LeslieXMOS/XU316-QF60-Development-Board-Hardware/EASYEDA_MODELS/IND-SMD_L7.0-W6.6-H3.0.step

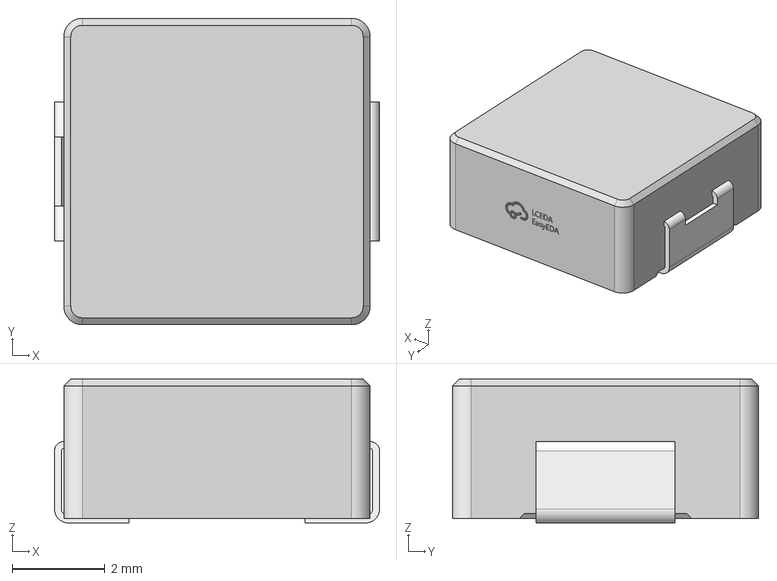
[picture p1: CAD file, 2026-09-23]
EASYEDA_MODELS/IND-SMD_L7.0-W6.6-H3.0.step
7.00 x 6.60 x 3.10 mm
