LeslieXMOS/XU316-QF60-Development-Board-Hardware/EASYEDA_MODELS/WSON-8_L8.0-W6.0-P1.27-TL-EP-1.step

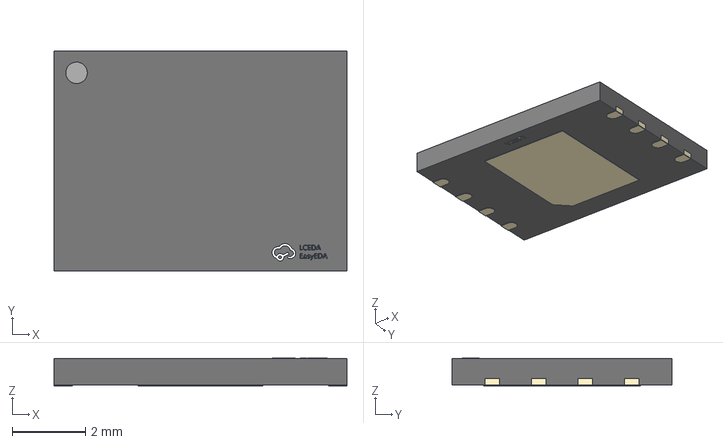
[picture p2: CAD file, 2026-09-11]
EASYEDA_MODELS/WSON-8_L8.0-W6.0-P1.27-TL-EP-1.step
8.00 x 6.00 x 0.751 mm
