LeslieXMOS/XU316-QF60-Development-Board-Hardware/EASYEDA_MODELS/SC-88-6P_L2.0-W1.3-H1.0-LS2.1.step

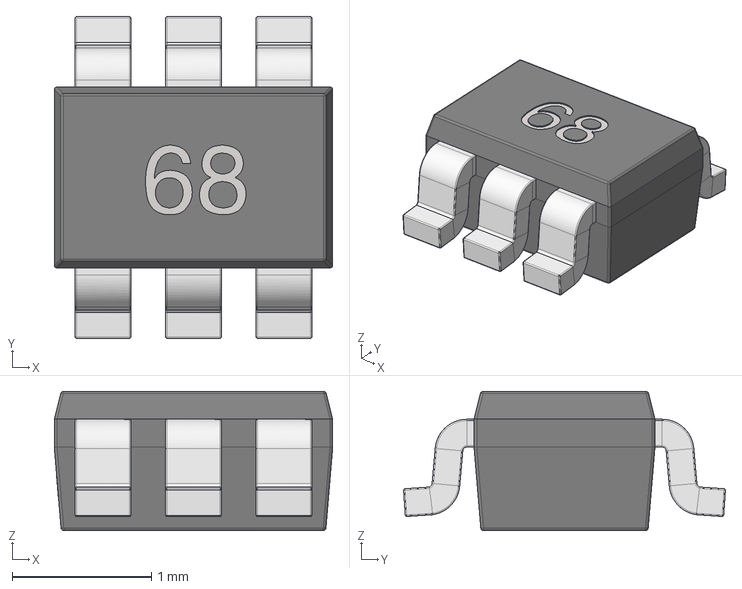
[picture p3: CAD file, 2026-09-11]
EASYEDA_MODELS/SC-88-6P_L2.0-W1.3-H1.0-LS2.1.step
2.00 x 2.31 x 1.00 mm
