LeslieXMOS/XU316-QF60-Development-Board-Hardware/EASYEDA_MODELS/USB-C-SMD_TYPE-C-6PIN-2MD-073.step

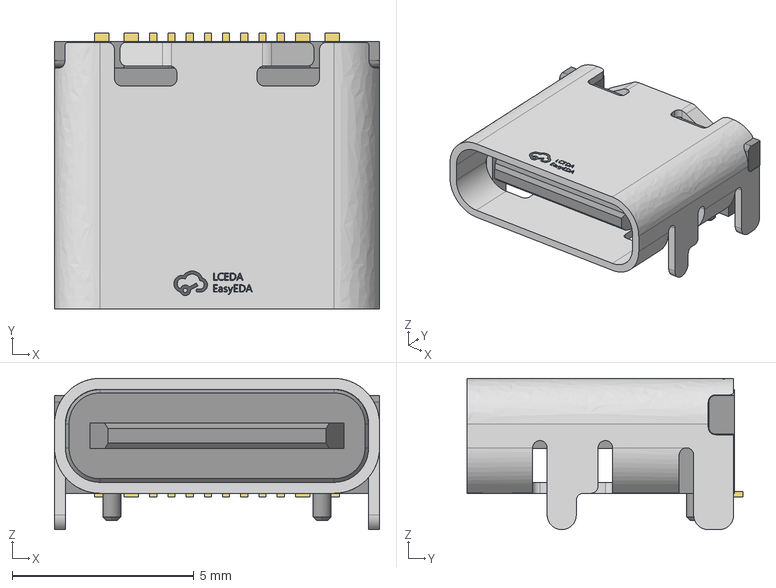
[picture p4: CAD file, 2026-09-11]
EASYEDA_MODELS/USB-C-SMD_TYPE-C-6PIN-2MD-073.step
8.94 x 7.58 x 4.16 mm
