LeslieXMOS/XU316-QF60-Development-Board-Hardware/EASYEDA_MODELS/SOT-563-6_L1.6-W1.2-P0.5-LS1.6-BL.step

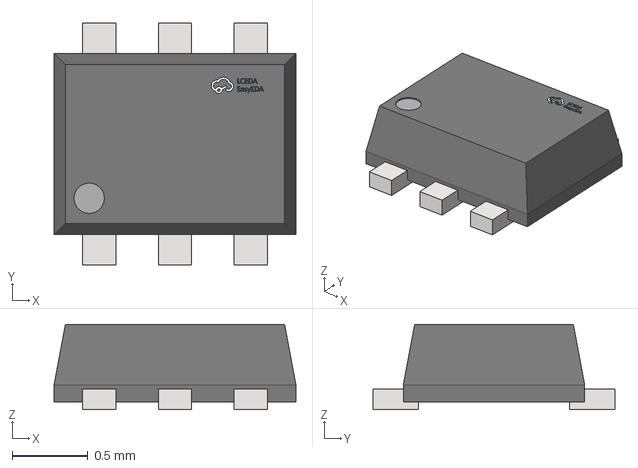
[picture p5: CAD file, 2026-09-11]
EASYEDA_MODELS/SOT-563-6_L1.6-W1.2-P0.5-LS1.6-BL.step
1.60 x 1.60 x 0.563 mm
