LeslieXMOS/XU316-QF60-Development-Board-Hardware/EASYEDA_MODELS/QFN-60_L7.0-W7.0-P0.40-TL-EP_XU316-1024.step

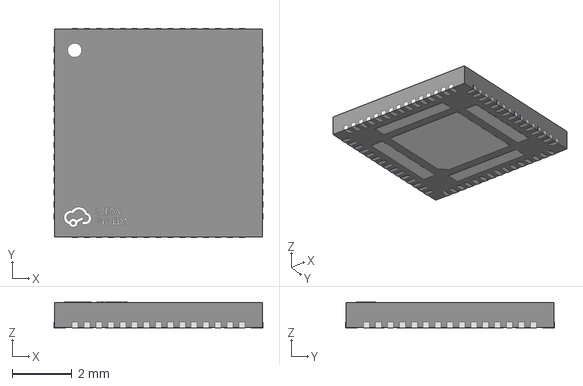
[picture p6: CAD file, 2026-09-11]
EASYEDA_MODELS/QFN-60_L7.0-W7.0-P0.40-TL-EP_XU316-1024.step
7.02 x 7.02 x 0.87 mm
