LeslieXMOS/XU316-QF60-Development-Board-Hardware/EASYEDA_MODELS/WSON-12_L3.0-W3.0-P0.50-TL-EP-2.step

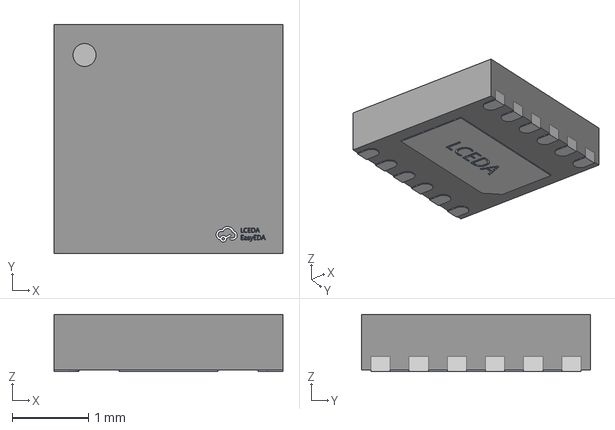
[picture p7: CAD file, 2026-09-11]
EASYEDA_MODELS/WSON-12_L3.0-W3.0-P0.50-TL-EP-2.step
3.00 x 3.00 x 0.751 mm
