LeslieXMOS/XU316-QF60-Development-Board-Hardware/EASYEDA_MODELS/CONN-TH_20P-P1.27_BH127V-20P-H49.step

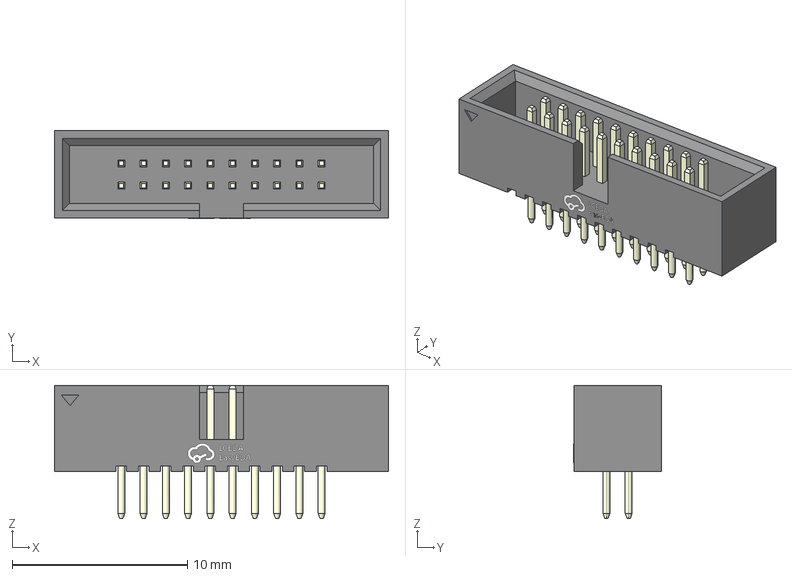
[picture p8: CAD file, 2026-09-11]
EASYEDA_MODELS/CONN-TH_20P-P1.27_BH127V-20P-H49.step
19.1 x 5.01 x 7.60 mm
