LeslieXMOS/XU316-QF60-Development-Board-Hardware/EASYEDA_MODELS/USON-8_L4.0-W3.0-H0.6-P0.80-BL_GD25Q32CNIGR.step

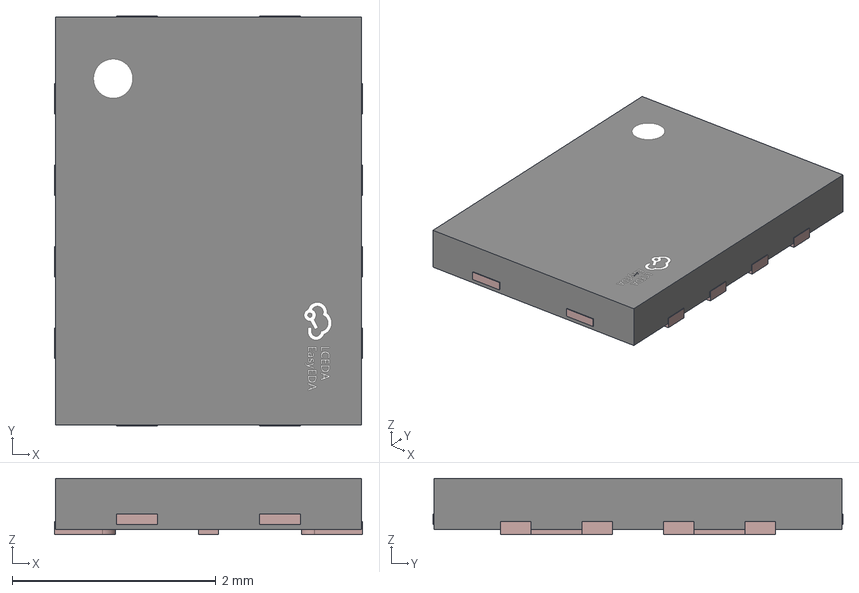
[picture p9: CAD file, 2026-09-11]
EASYEDA_MODELS/USON-8_L4.0-W3.0-H0.6-P0.80-BL_GD25Q32CNIGR.step
3.02 x 4.02 x 0.551 mm
