LeslieXMOS/XU316-QF60-Development-Board-Hardware/EASYEDA_MODELS/SOT-563-6P_L1.6-W1.2-H0.6-LS1.6-P0.50.step

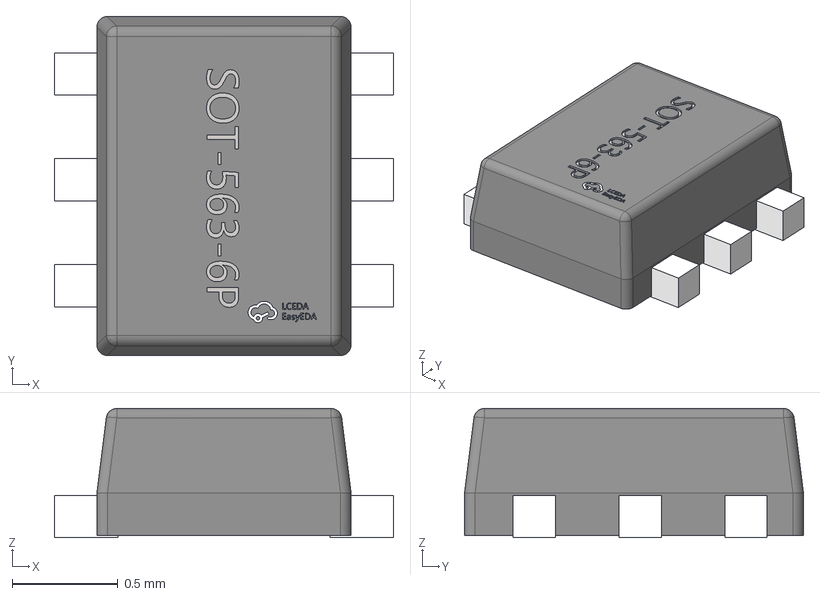
[picture p10: CAD file, 2026-09-11]
EASYEDA_MODELS/SOT-563-6P_L1.6-W1.2-H0.6-LS1.6-P0.50.step
1.60 x 1.60 x 0.611 mm
