LeslieXMOS/XU316-QF60-Development-Board-Hardware/EASYEDA_MODELS/VSON-10_L3.0-W3.0-H0.6-P0.50_TPS.step

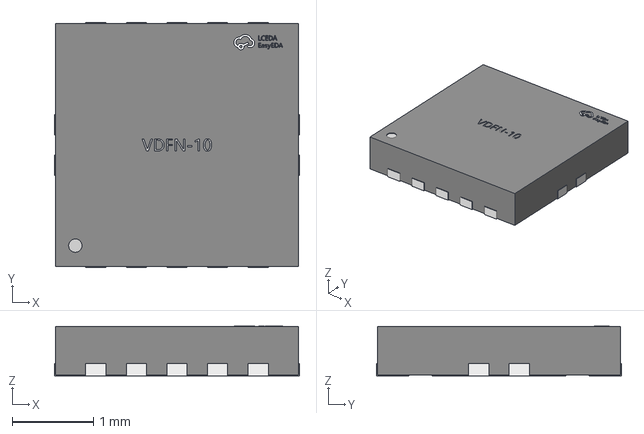
[picture p11: CAD file, 2026-09-11]
EASYEDA_MODELS/VSON-10_L3.0-W3.0-H0.6-P0.50_TPS.step
3.02 x 3.02 x 0.611 mm
