LeslieXMOS/XU316-QF60-Development-Board-Hardware/xu316_core_board_pcb.pdf

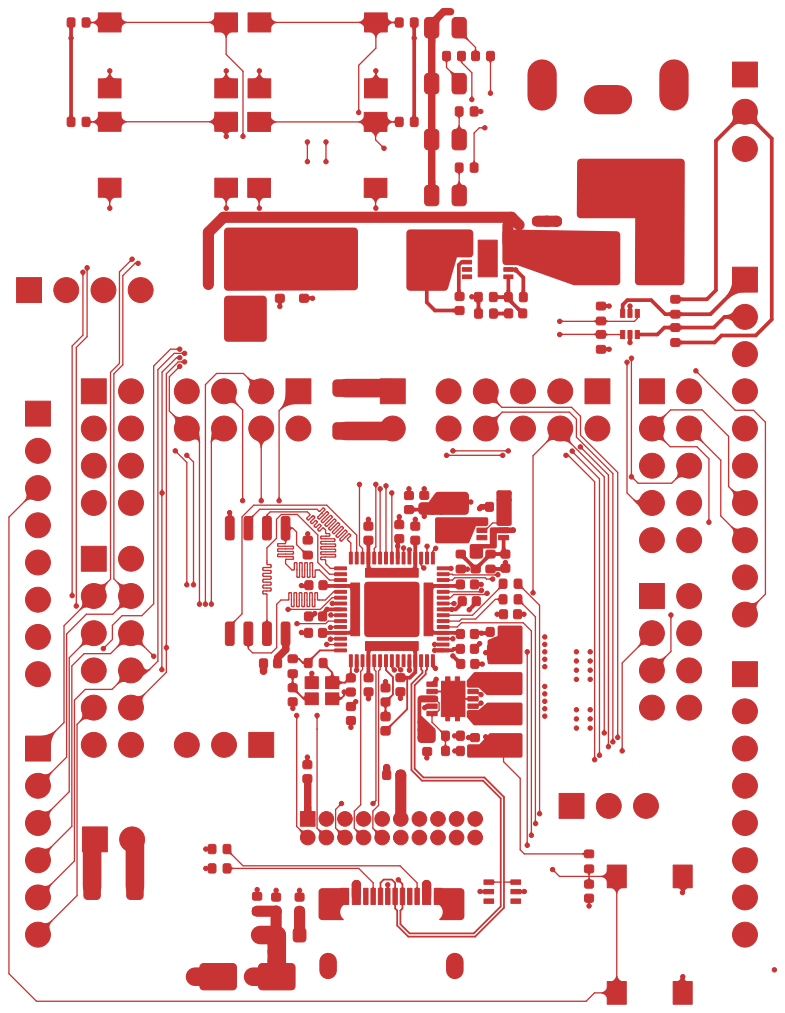
[picture p12: page 1]

Id: 1/11 Title: File: xu316_core_board.kicad_pcb Sheet:

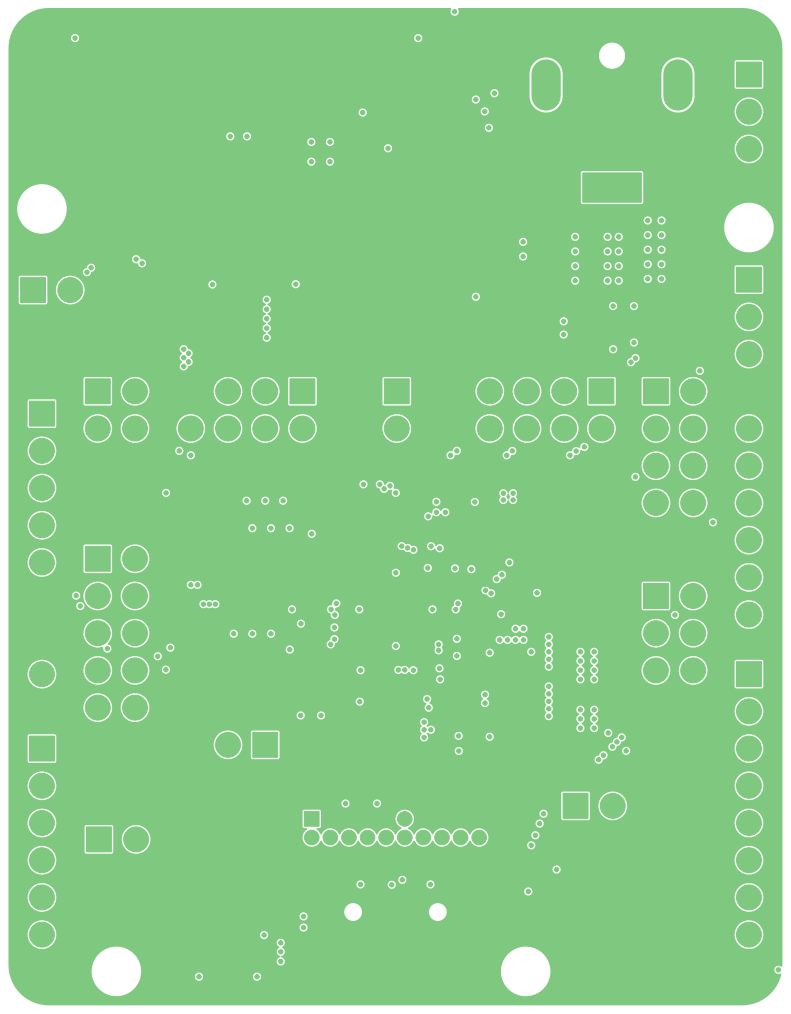
[picture p13: page 2]

Id: 2/11 Title: File: xu316_core_board.kicad_pcb Sheet:

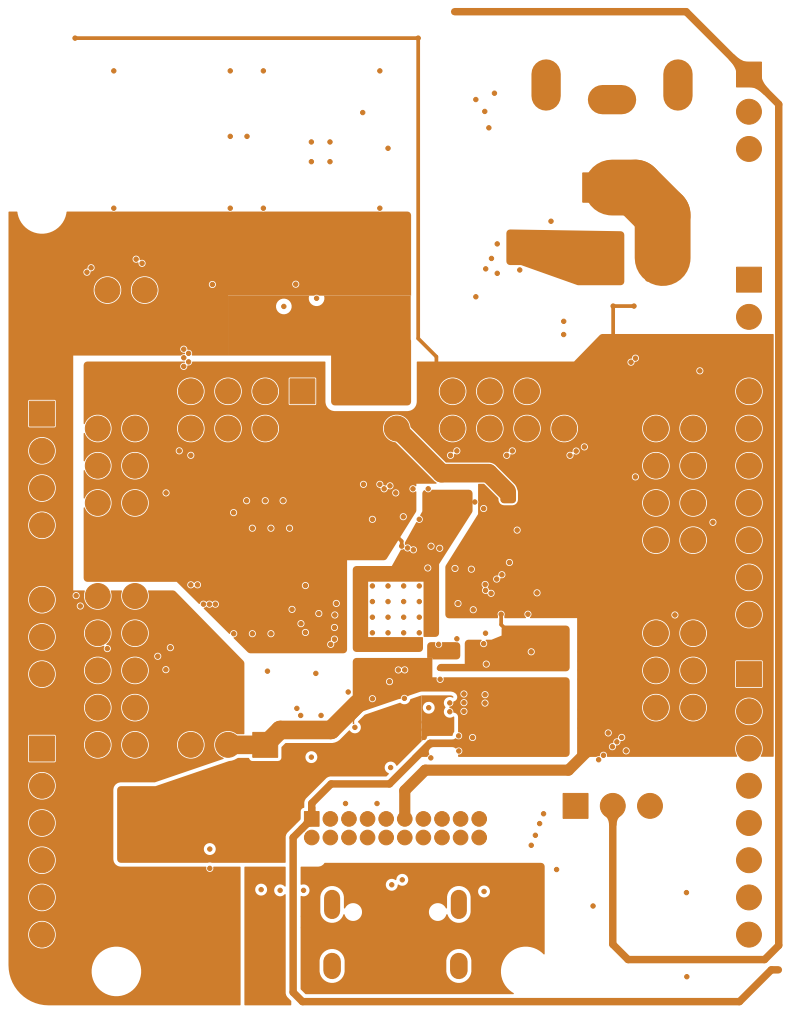
[picture p14: page 3]

Id: 3/11 Title: File: xu316_core_board.kicad_pcb Sheet:

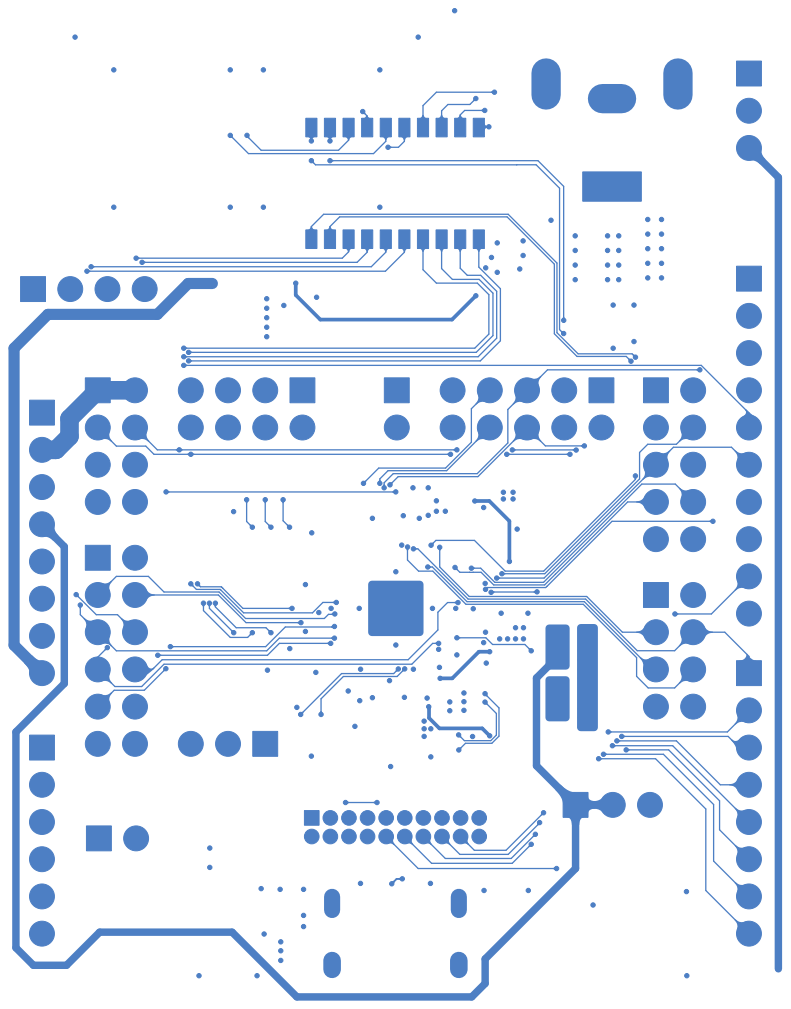
[picture p15: page 4]

Id: 4/11 Title: File: xu316_core_board.kicad_pcb Sheet:

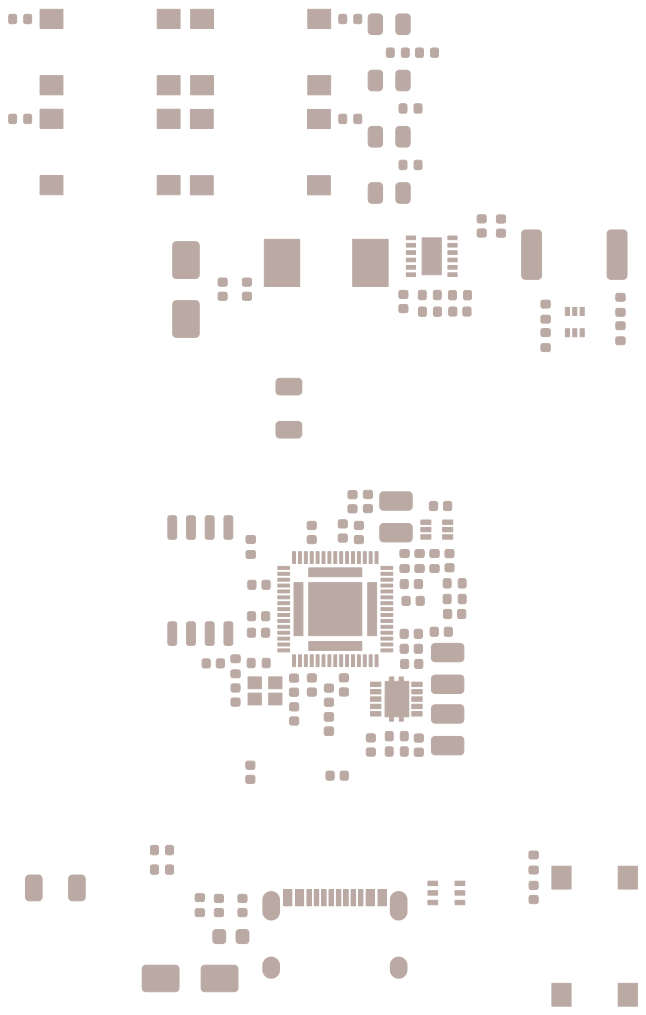
[picture p16: page 5]

Id: 5/11 Title: File: xu316_core_board.kicad_pcb Sheet:

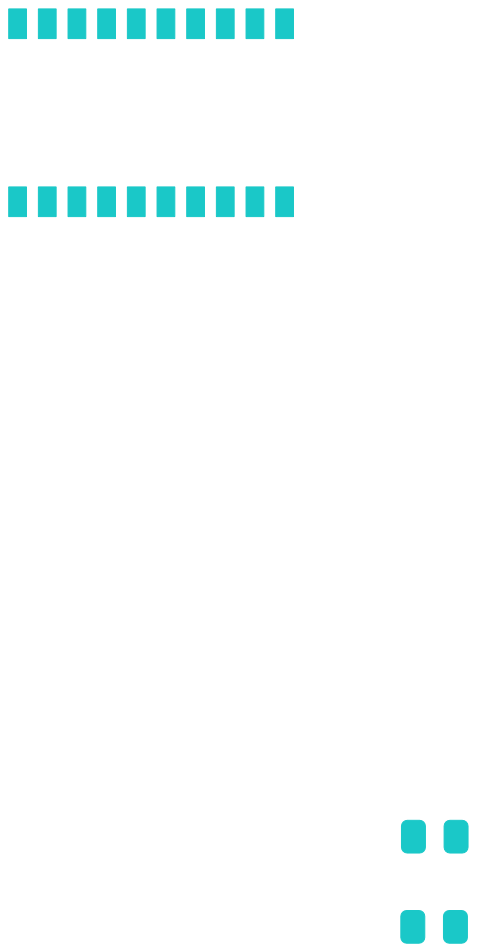
[picture p17: page 6]

Id: 6/11 Title: File: xu316_core_board.kicad_pcb Sheet:

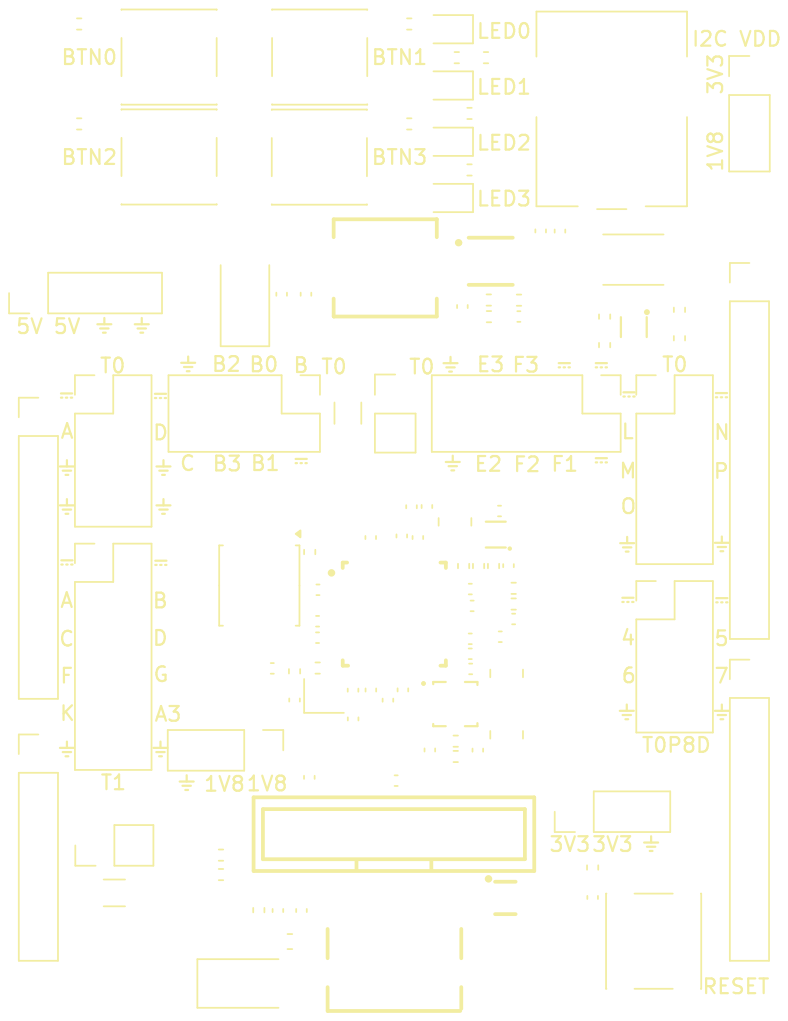
[picture p18: page 7]

Id: 7/11 Title: File: xu316_core_board.kicad_pcb Sheet:

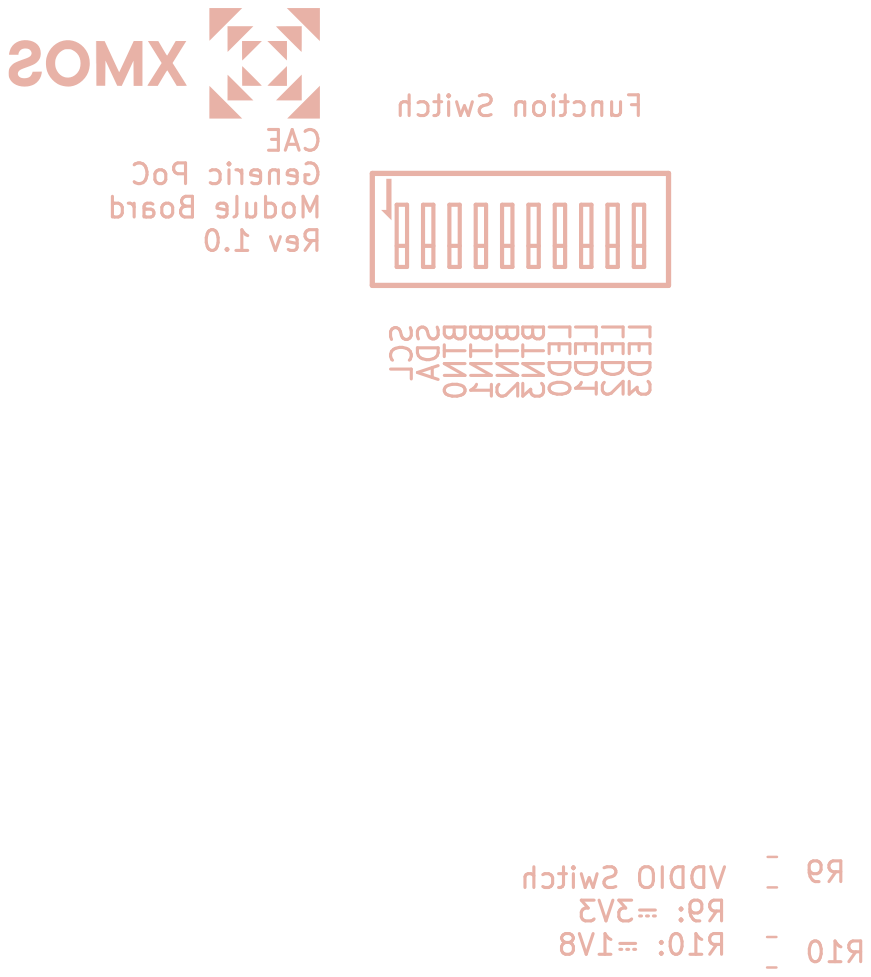
[picture p19: page 8]

Id: 8/11 Title: File: xu316_core_board.kicad_pcb Sheet:

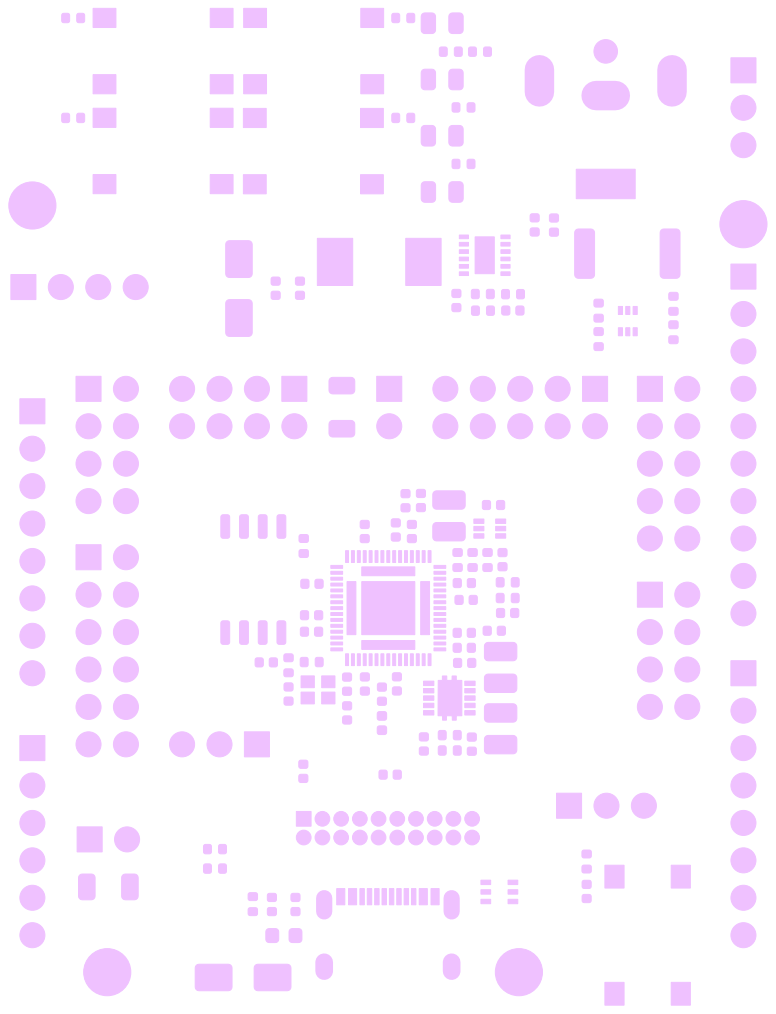
[picture p20: page 9]

Id: 9/11 Title: File: xu316_core_board.kicad_pcb Sheet:

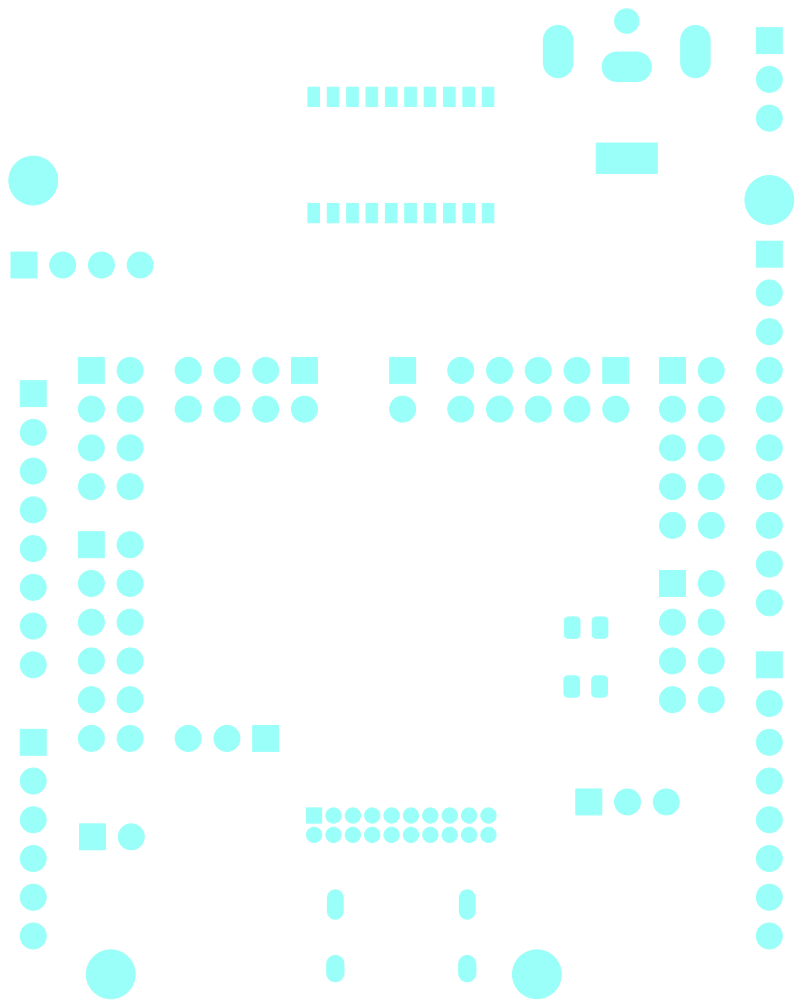
[picture p21: page 10]

Id: 10/11 Title: File: xu316_core_board.kicad_pcb Sheet:

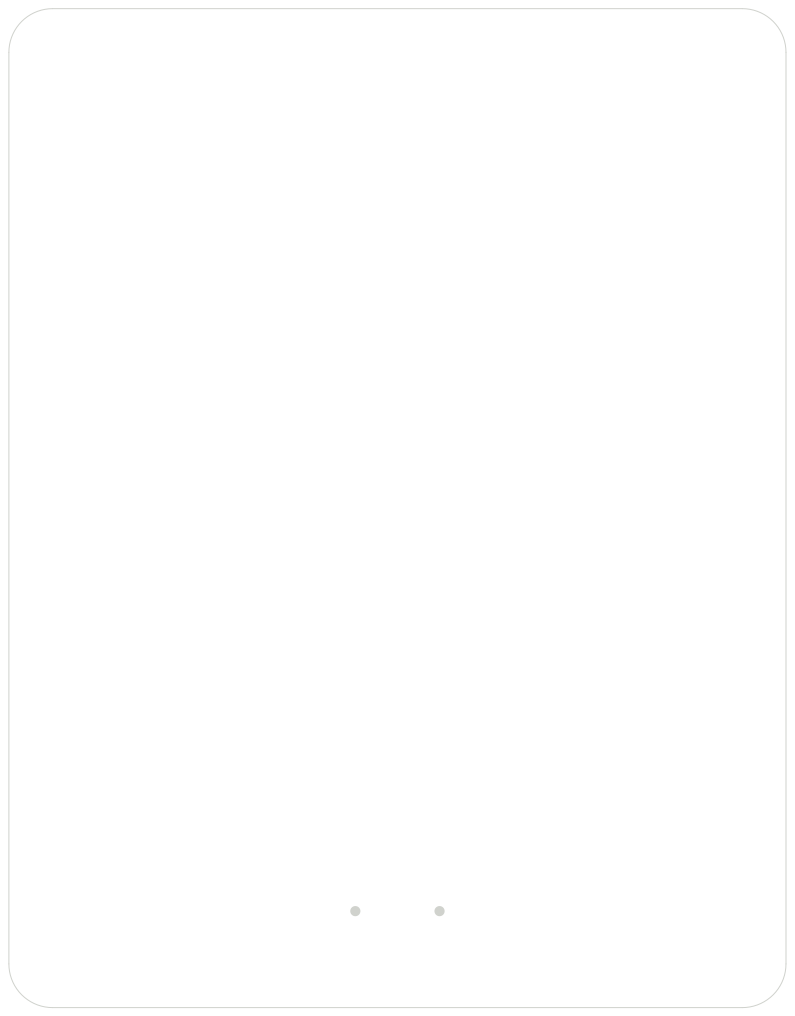
[picture p22: page 11]

Id: 11/11 Title: File: xu316_core_board.kicad_pcb Sheet:
