LeslieXMOS/XU316-QF60-Development-Board-Hardware/xu316_core_board_sch.pdf

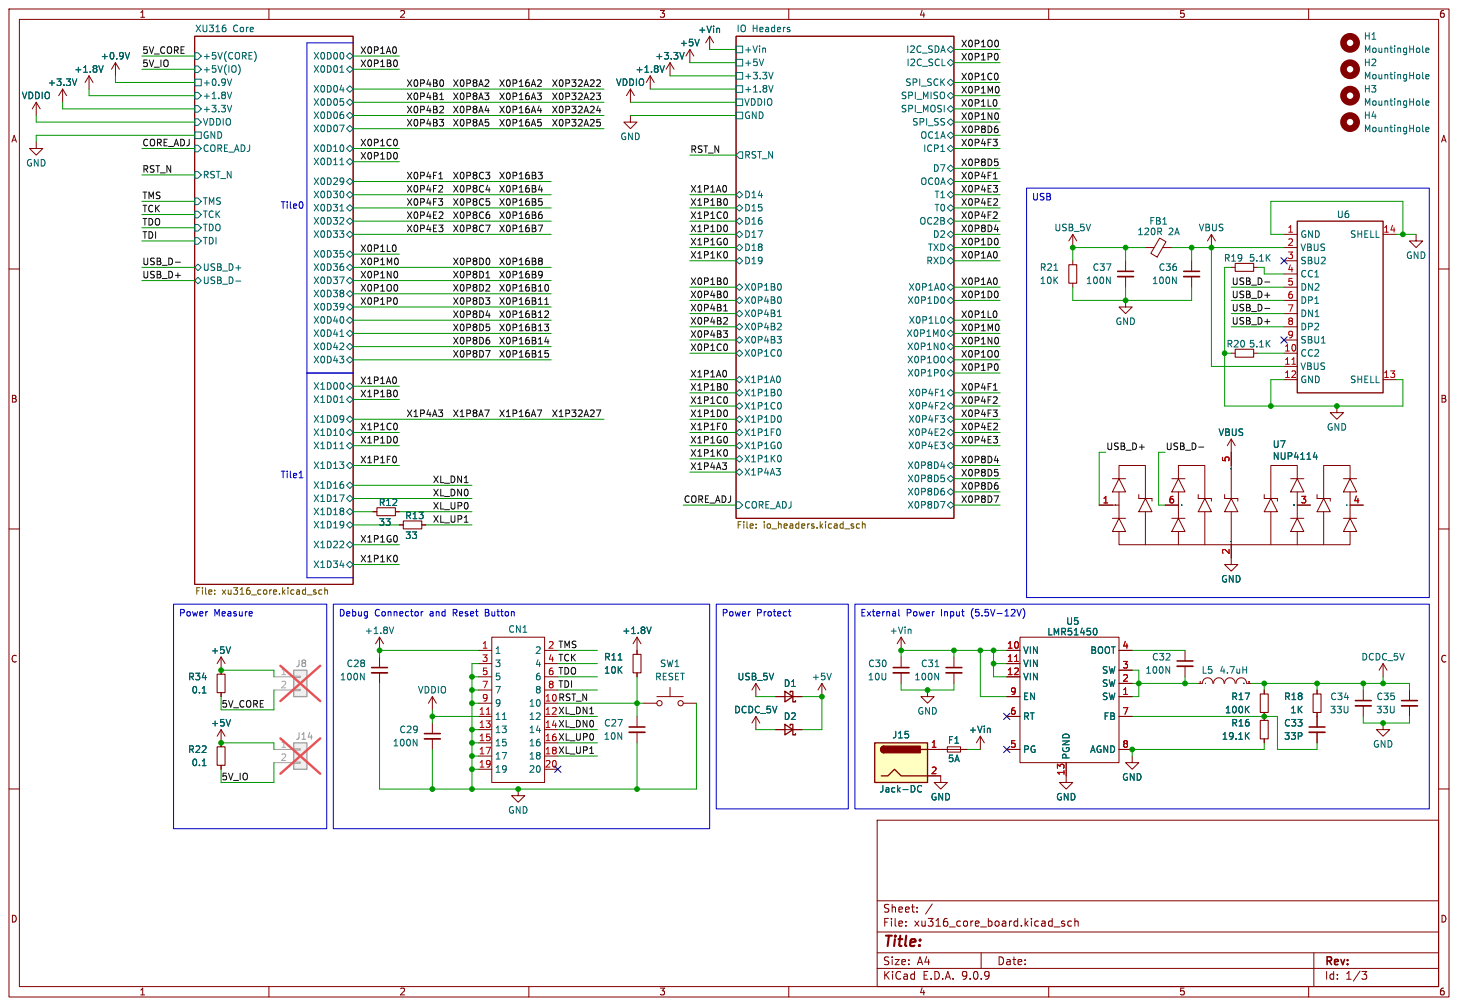
[picture p23: page 1]

Id: 1/3 Title: File: xu316_core_board.kicad_sch Sheet: /

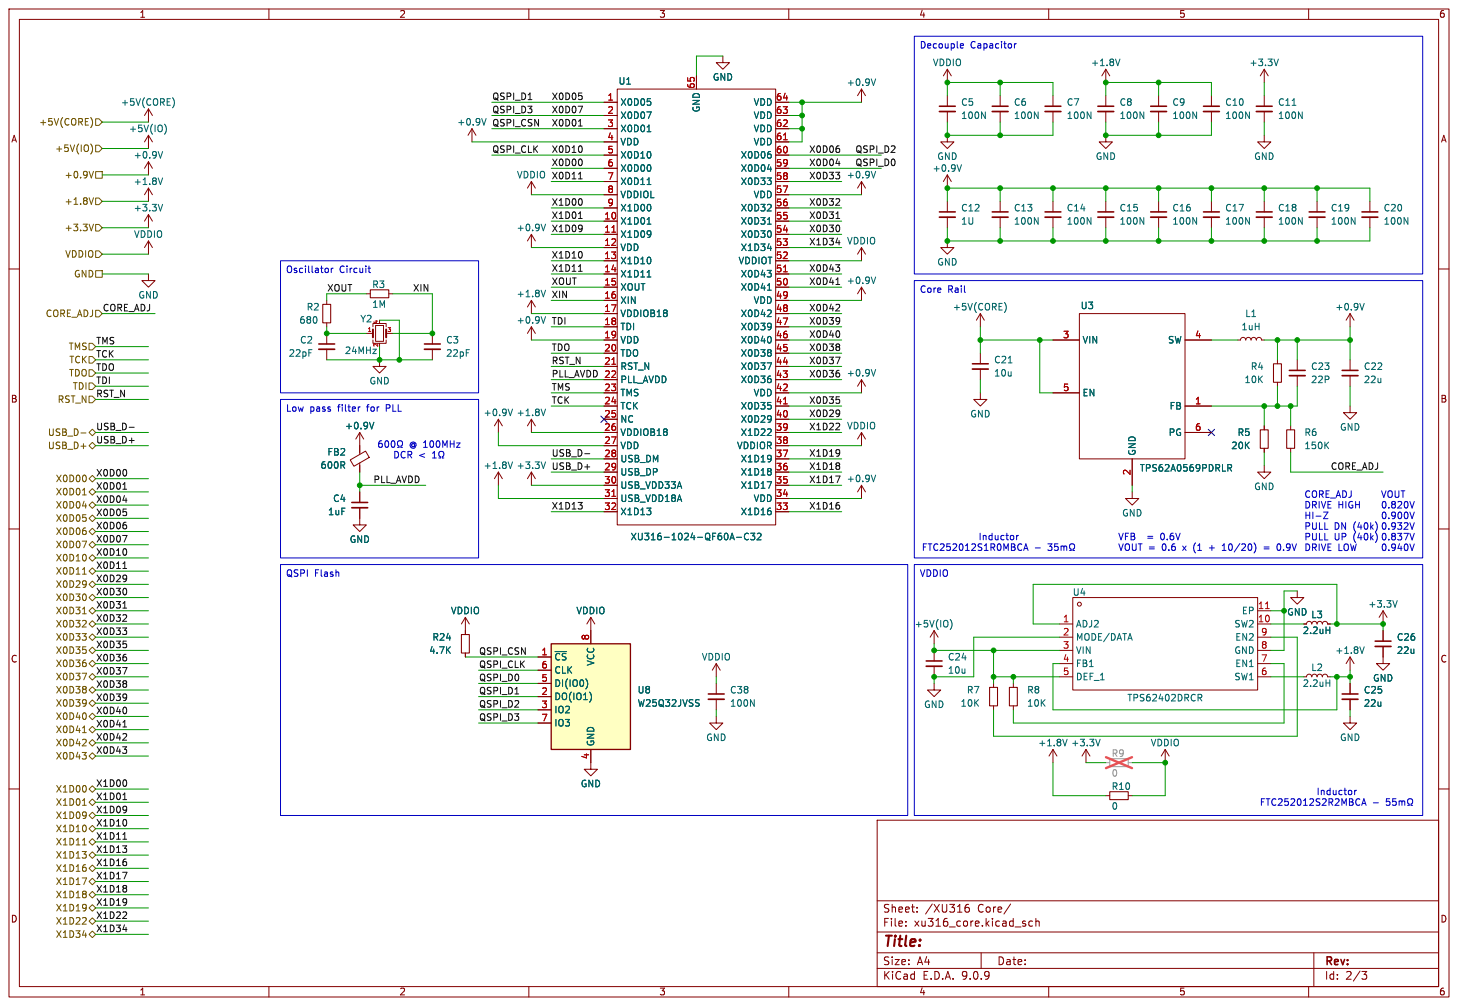
[picture p24: page 2]

2 SW 4 FB 1 PG 6 U3 TPS62A0569PDRLR GND

HI-Z PULL DN (40k) PULL UP (40k) DRIVE LOW

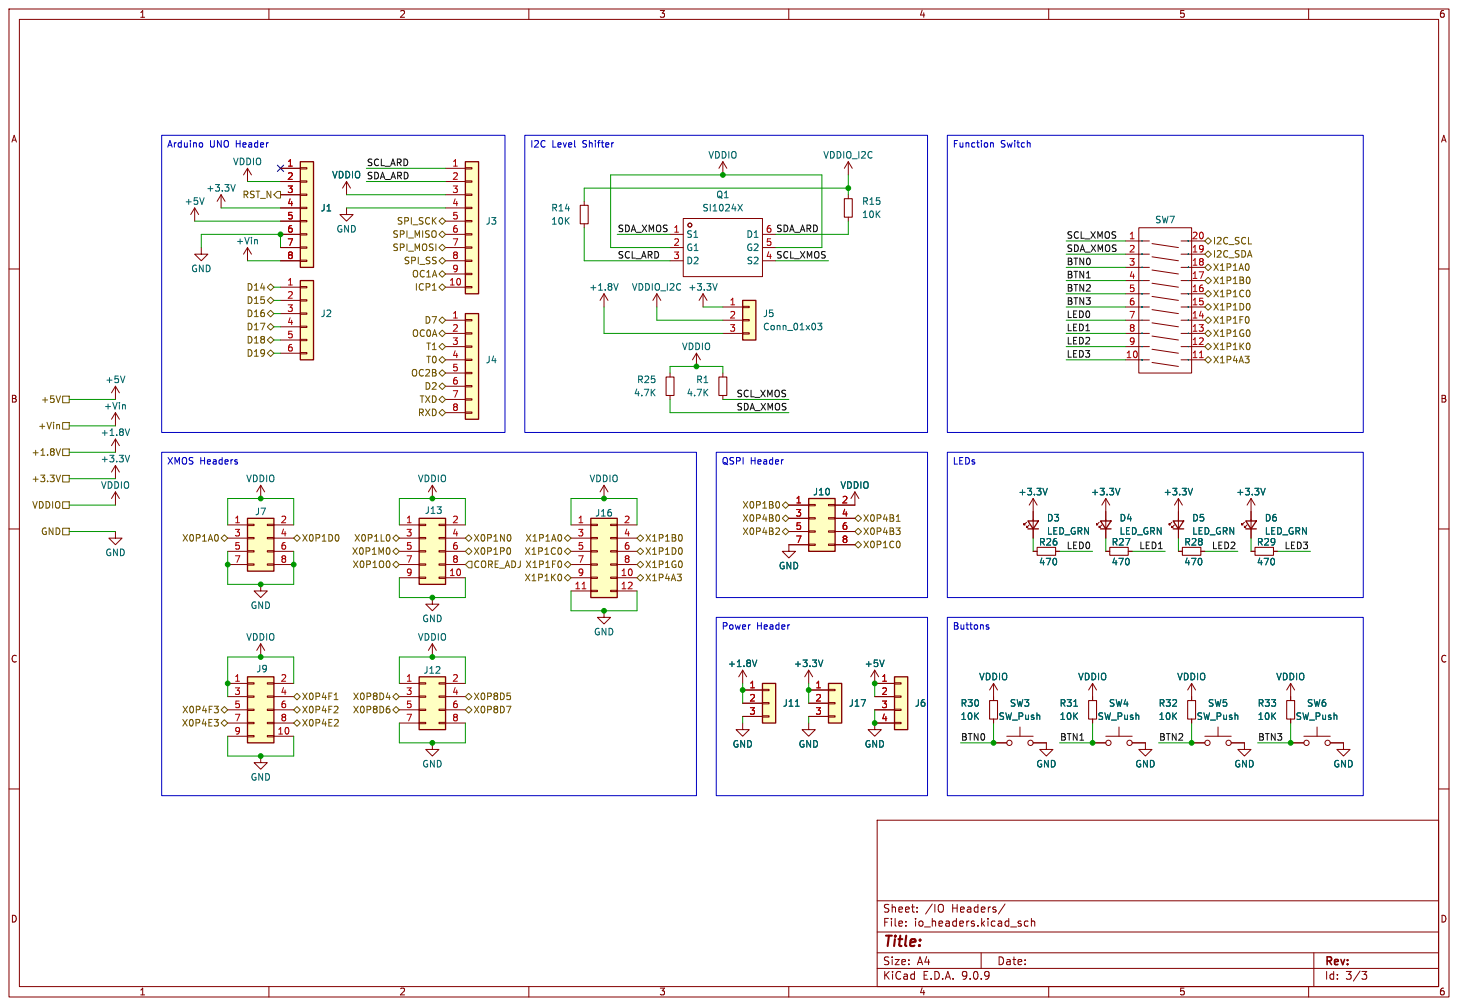
[picture p25: page 3]
