LeslieXMOS/XU316-QF60-Development-Board-Hardware/xu316_core_board.kicad_pcb

## KiCad design xu316_core_board.kicad_pcb (2026-09-29)

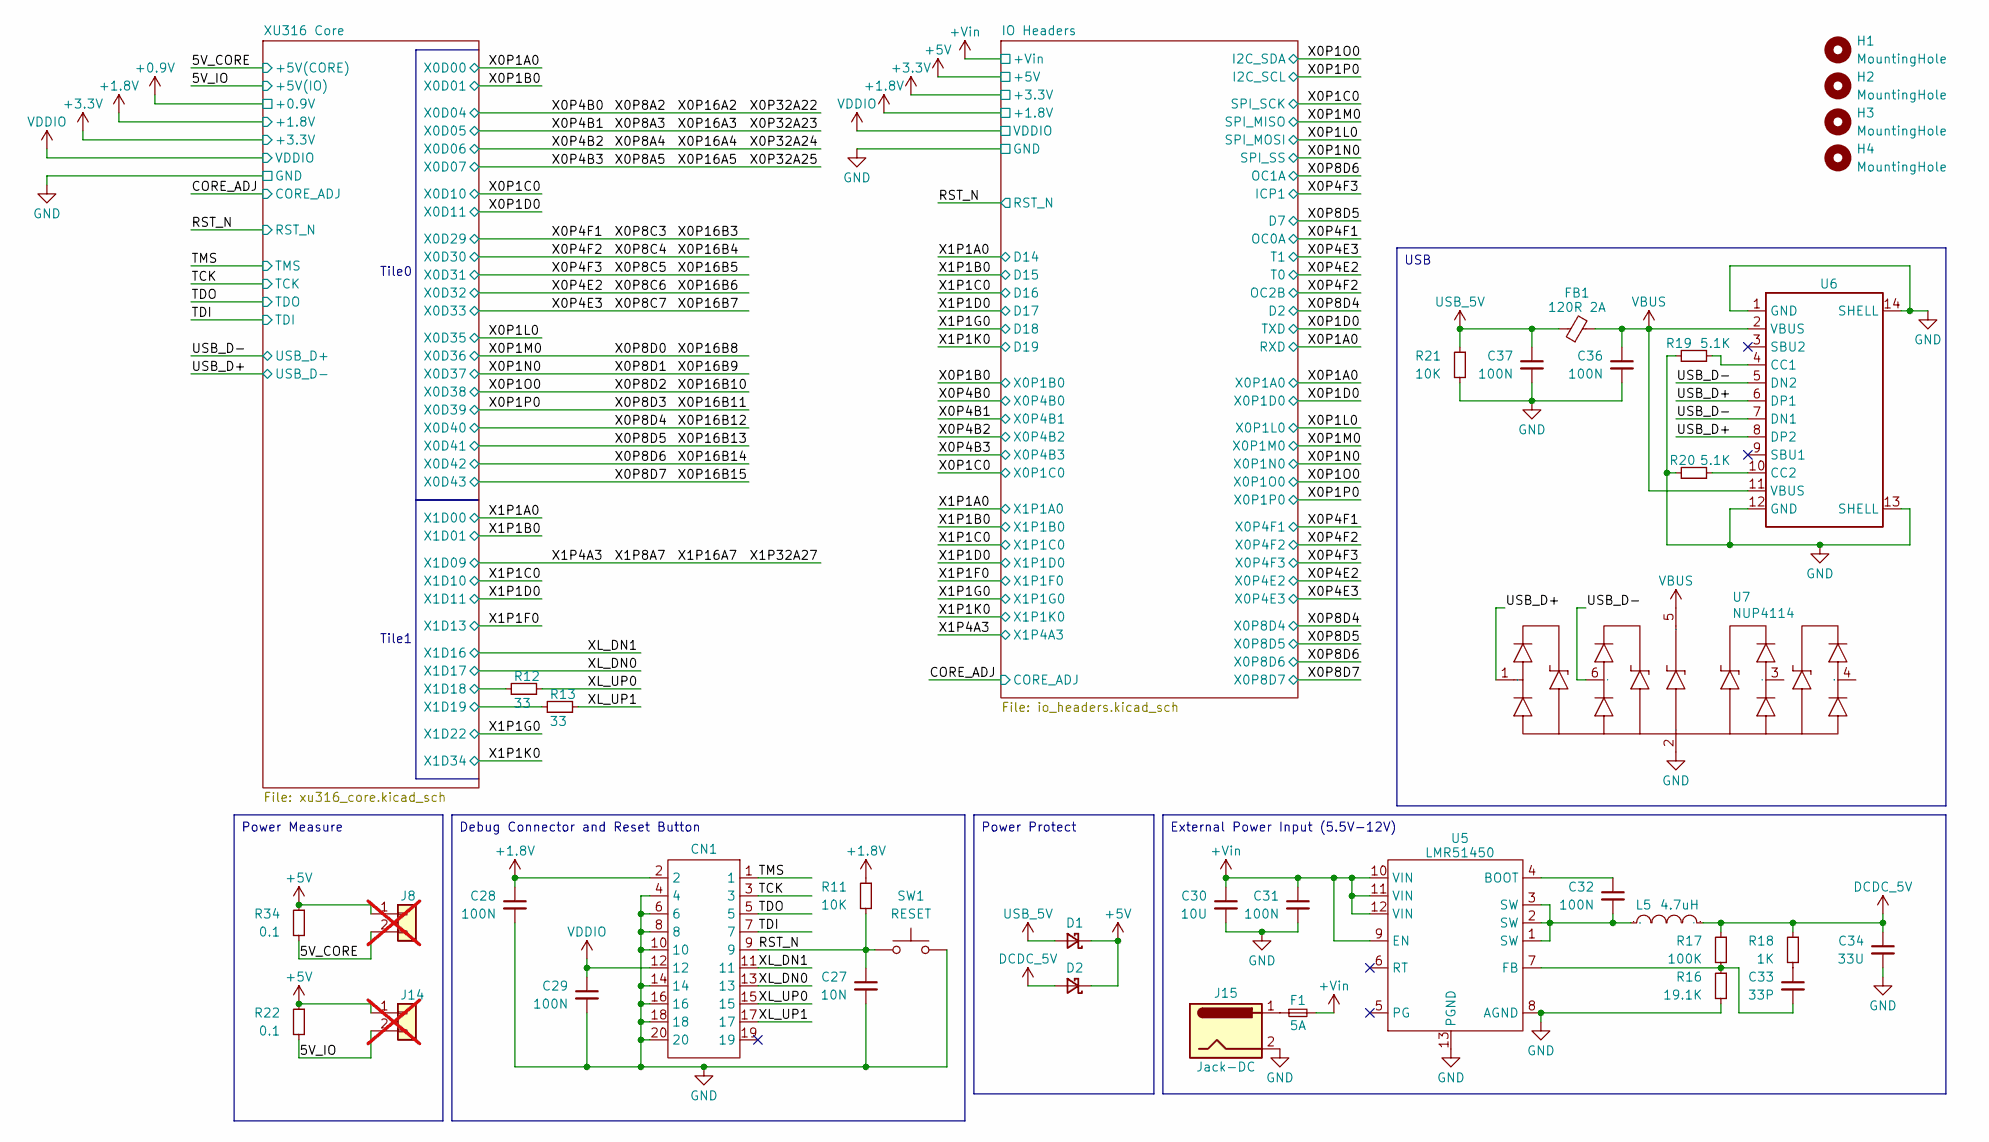
[picture p26: schematic xu316_core_board.kicad_sch]

Parts:
C27: 10N; C_0402_1005Metric
C28, C29, C31, C32, C36, C37: 100N; C_0402_1005Metric
C30: 10U; C_1206_3216Metric
C33: 33P; C_0402_1005Metric
C34: 33U; CP_Elec_4x5.4; JLCParts C53200078
CN1: HX JN1.27-2x10P ZZ H4.9; CONN-TH_20P-P1.27_BH127V-20P-H49; Manufacturer Part HX JN1.27-2x10P ZZ H4.9; LCSC Part Name 1.27mm 2x10P 排数:2 每排P数:10
D1, D2: D_Schottky_Small; D_SMA
F1: 5A; Fuse_2512_6332Metric
FB1: 120R 2A; L_0603_1608Metric
H1, H2, H3, H4: MountingHole; MountingHole_3.2mm_M3
J8, J14: Conn_01x02; PinHeader_1x02_P2.54mm_Vertical; not fitted
J15: Jack-DC; BarrelJack_GCT_DCJ200-10-A_Horizontal
L5: 4.7uH; IND-SMD_L7.0-W6.6; Manufacturer Part FXL0630-4R7-M; LCSC Part Name 4.7uH ±20% 9A
R11, R21: 10K; R_0402_1005Metric
R12, R13: 33; R_0402_1005Metric
R16: 19.1K; R_0402_1005Metric
R17: 100K; R_0402_1005Metric
R18: 1K; R_0402_1005Metric
R19, R20: 5.1K; R_0402_1005Metric
R22, R34: 0.1; R_1206_3216Metric; JLCPart C411236
SW1: RESET; SW_Push_1P1T_NO_6x6mm_H9.5mm
U5: LMR51450; WSON-12_L3.0-W3.0-P0.50-TL-EP-2; Manufacturer Part LMR51450FNDRRR; LCSC Part Name 降压型 5A 4V~36V
U6: USB-C-SMD_TYPE-C-6PIN-2MD-073; Manufacturer Part TypeC-16PIN; LCSC Part Name TypeC-16PIN
U7: NUP4114; SC-88-6_L2.0-W1.3-P0.65-LS2.1-BL; Manufacturer Part NUP4114UCLW1T1G; LCSC Part Name NUP4114UCLW1T1G 停产

Connections:
+1.8V: C28.1, CN1.2, R11.1; also elsewhere on the board
+5V: D1.1 (K), D2.1 (K), J8.1, J14.1, R22.1, R34.1; also elsewhere on the board
+5V(CORE): J8.2, R34.2; also elsewhere on the board
+5V(IO): J14.2, R22.2; also elsewhere on the board
+Vin: C30.1, C31.1, F1.2, U5.9 (EN), U5.10 (VIN), U5.11 (VIN), U5.12 (VIN); also elsewhere on the board
/RST_N: C27.1, CN1.9, R11.2, SW1.1; also elsewhere on the board
/TCK: CN1.3; also elsewhere on the board
/TDI: CN1.7; also elsewhere on the board
/TDO: CN1.5; also elsewhere on the board
/TMS: CN1.1; also elsewhere on the board
/USB_D+: U6.6 (DP1), U6.8 (DP2), U7.1; also elsewhere on the board
/USB_D-: U6.5 (DN2), U6.7 (DN1), U7.6; also elsewhere on the board
/XL_DN0: CN1.13; also elsewhere on the board
/XL_DN1: CN1.11; also elsewhere on the board
/XL_UP0: CN1.15, R12.1
/XL_UP1: CN1.17, R13.1
/XU316 Core/X1D18: R12.2; also elsewhere on the board
/XU316 Core/X1D19: R13.2; also elsewhere on the board
DCDC_5V: C34.1, D2.2 (A), L5.2, R17.1, R18.1
GND: C27.2, C28.2, C29.2, C30.2, C31.2, C34.2, C36.2, C37.2, CN1.4, CN1.6, CN1.8, CN1.10, CN1.14, CN1.16, CN1.18, CN1.20, J15.2, R16.2, R19.2, R20.2, R21.2, SW1.2, U5.8 (AGND), U5.13 (PGND), U6.1 (GND), U6.12 (GND), U6.13 (SHELL), U6.14 (SHELL), U7.2; also elsewhere on the board
unnamed: C32.2, L5.1, U5.1 (SW), U5.2 (SW), U5.3 (SW)
unnamed: C33.1, R18.2
unnamed: F1.1, J15.1
unnamed: C32.1, U5.4 (BOOT)
unnamed: C33.2, R16.1, R17.2, U5.7 (FB)
unnamed: R19.1, U6.4 (CC1)
unnamed: R20.1, U6.10 (CC2)
USB_5V: C37.1, D1.2 (A), FB1.1, R21.1
VBUS: C36.1, FB1.2, U6.2 (VBUS), U6.11 (VBUS), U7.5
VDDIO: C29.1, CN1.12; also elsewhere on the board

Notes on the sheet:
Tile0
Tile1
Debug Connector and Reset Button
Power Protect
External Power Input (5.5V-12V)
USB
Power Measure

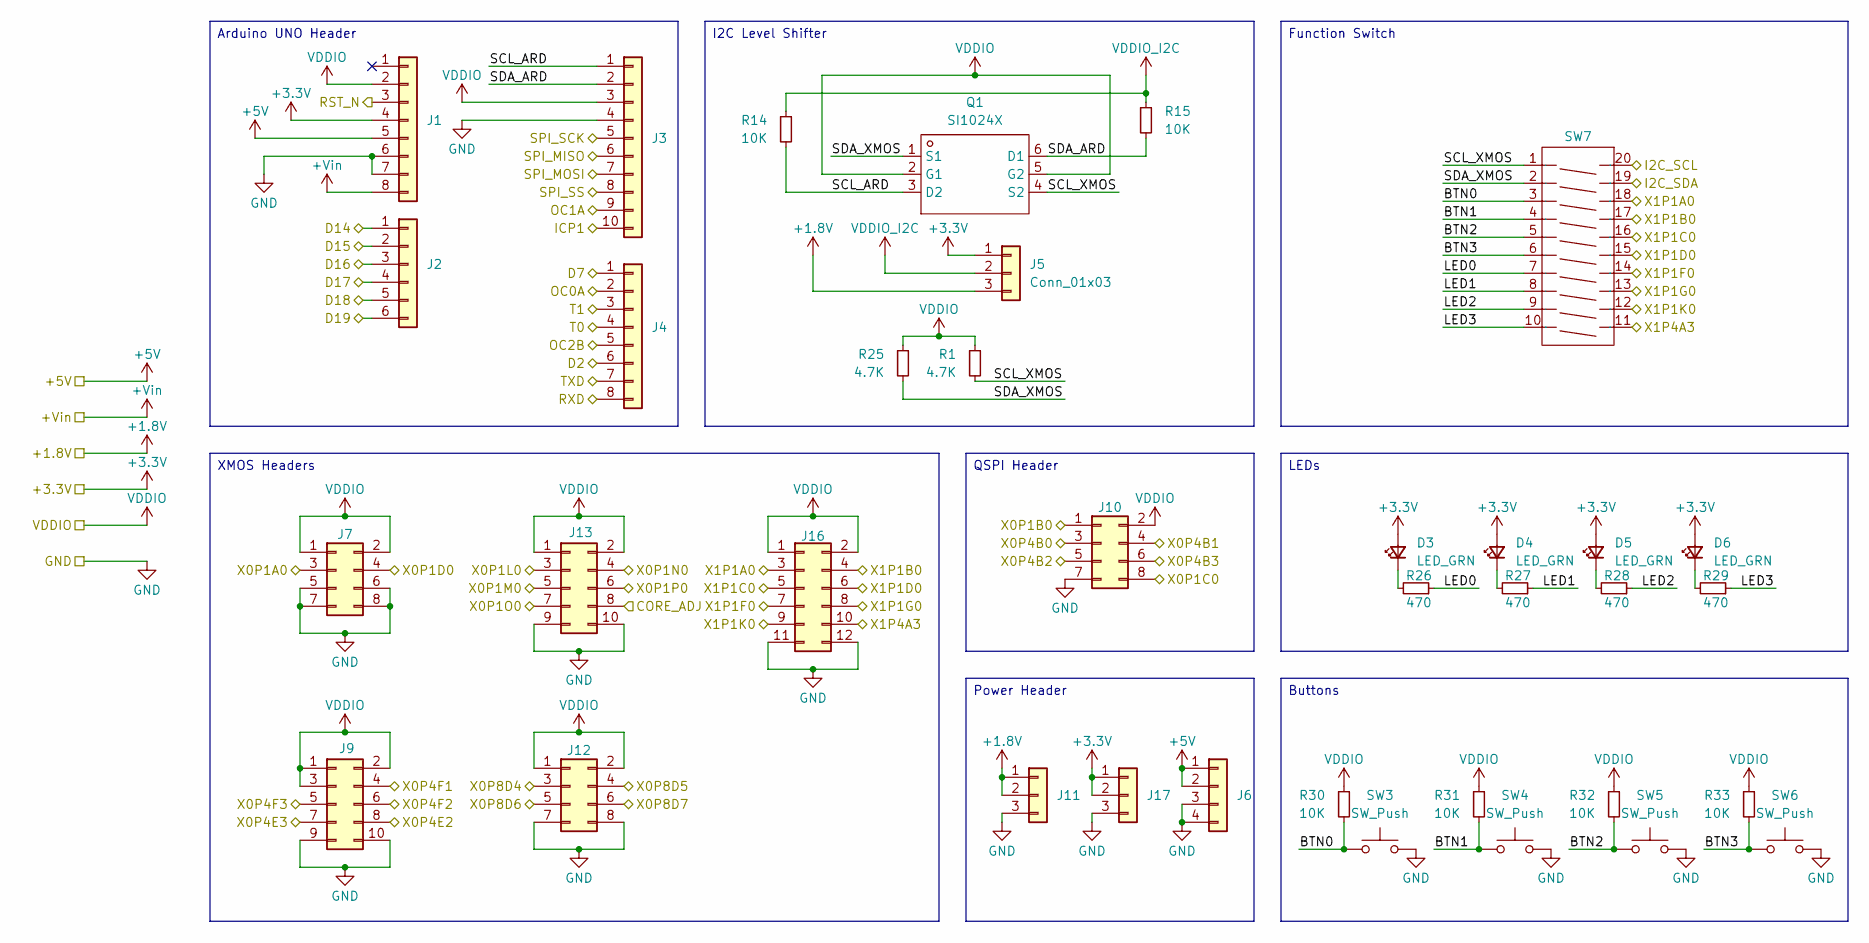
[picture p27: schematic io_headers.kicad_sch]

Parts:
D3, D4, D5, D6: LED_GRN; LED_0805_2012Metric
J1, J4: Conn_01x08; PinHeader_1x08_P2.54mm_Vertical
J2: Conn_01x06; PinHeader_1x06_P2.54mm_Vertical
J3: Conn_01x10; PinHeader_1x10_P2.54mm_Vertical
J5, J11, J17: Conn_01x03; PinHeader_1x03_P2.54mm_Vertical
J6: Conn_01x04; PinHeader_1x04_P2.54mm_Vertical
J7, J10, J12: Conn_02x04_Odd_Even; PinHeader_2x04_P2.54mm_Vertical
J9, J13: Conn_02x05_Odd_Even; PinHeader_2x05_P2.54mm_Vertical
J16: Conn_02x06_Odd_Even; PinHeader_2x06_P2.54mm_Vertical
Q1: SI1024X; SOT-563_L1.6-W1.2-P0.50-LS1.6-BL; Manufacturer Part SI1024X-T1-GE3; LCSC Part Name 2个N沟道 耐压:20V 电流:600mA
R1, R25: 4.7K; R_0402_1005Metric
R14, R15, R30, R31, R32, R33: 10K; R_0402_1005Metric
R26, R27, R28, R29: 470; R_0402_1005Metric
SW3, SW4, SW5, SW6: SW_Push; SW_Push_1P1T_NO_6x6mm_H9.5mm
SW7: SW-SMD_20P-L14.3-W5.4-P1.27-LS8.3; Manufacturer Part DS-10P; LCSC Part Name 1.27mm间距10位 贴片黑色S脚 拨码开关

Connections:
+1.8V: J5.3, J11.1, J11.2; also elsewhere on the board
+3.3V: D3.2 (A), D4.2 (A), D5.2 (A), D6.2 (A), J1.4, J5.1, J17.1, J17.2; also elsewhere on the board
+5V: J1.5, J6.1, J6.2; also elsewhere on the board
+Vin: J1.8; also elsewhere on the board
/CORE_ADJ: J13.8; also elsewhere on the board
/IO Headers/BTN0: R30.2, SW3.1, SW7.3
/IO Headers/BTN1: R31.2, SW4.1, SW7.4
/IO Headers/BTN2: R32.2, SW5.1, SW7.5
/IO Headers/BTN3: R33.2, SW6.1, SW7.6
/IO Headers/LED0: R26.1, SW7.7
/IO Headers/LED1: R27.1, SW7.8
/IO Headers/LED2: R28.1, SW7.9
/IO Headers/LED3: R29.1, SW7.10
/IO Headers/SCL_ARD: J3.1, Q1.3 (D2), R14.2
/IO Headers/SCL_XMOS: Q1.4 (S2), R1.2, SW7.1
/IO Headers/SDA_ARD: J3.2, Q1.6 (D1), R15.2
/IO Headers/SDA_XMOS: Q1.1 (S1), R25.2, SW7.2
/RST_N: J1.3; also elsewhere on the board
/X0P1A0: J4.8, J7.3; also elsewhere on the board
/X0P1B0: J10.1; also elsewhere on the board
/X0P1C0: J3.5, J10.8; also elsewhere on the board
/X0P1D0: J4.7, J7.4; also elsewhere on the board
/X0P1L0: J3.7, J13.3; also elsewhere on the board
/X0P16A2: J10.3; also elsewhere on the board
/X0P16A3: J10.4; also elsewhere on the board
/X0P16A4: J10.5; also elsewhere on the board
/X0P16A5: J10.6; also elsewhere on the board
/X0P16B3: J4.2, J9.4; also elsewhere on the board
/X0P16B4: J4.5, J9.6; also elsewhere on the board
/X0P16B5: J3.10, J9.5; also elsewhere on the board
/X0P16B6: J4.4, J9.8; also elsewhere on the board
/X0P16B7: J4.3, J9.7; also elsewhere on the board
/X0P16B8: J3.6, J13.5; also elsewhere on the board
/X0P16B9: J3.8, J13.4; also elsewhere on the board
/X0P16B10: J13.7, SW7.19; also elsewhere on the board
/X0P16B11: J13.6, SW7.20; also elsewhere on the board
/X0P16B12: J4.6, J12.3; also elsewhere on the board
/X0P16B13: J4.1, J12.4; also elsewhere on the board
/X0P16B14: J3.9, J12.5; also elsewhere on the board
/X0P16B15: J12.6; also elsewhere on the board
/X1P1A0: J2.1, J16.3, SW7.18; also elsewhere on the board
/X1P1B0: J2.2, J16.4, SW7.17; also elsewhere on the board
/X1P1C0: J2.3, J16.5, SW7.16; also elsewhere on the board
/X1P1D0: J2.4, J16.6, SW7.15; also elsewhere on the board
/X1P1F0: J16.7, SW7.14; also elsewhere on the board
/X1P1G0: J2.5, J16.8, SW7.13; also elsewhere on the board
/X1P1K0: J2.6, J16.9, SW7.12; also elsewhere on the board
/X1P16A7: J16.10, SW7.11; also elsewhere on the board
GND: J1.6, J1.7, J3.4, J6.3, J6.4, J7.5, J7.6, J7.7, J7.8, J9.9, J9.10, J10.7, J11.3, J12.7, J12.8, J13.9, J13.10, J16.11, J16.12, J17.3, SW3.2, SW4.2, SW5.2, SW6.2; also elsewhere on the board
unnamed: D3.1 (K), R26.2
unnamed: D4.1 (K), R27.2
unnamed: D5.1 (K), R28.2
unnamed: D6.1 (K), R29.2
VDDIO: J1.2, J3.3, J7.1, J7.2, J9.1, J9.2, J9.3, J10.2, J12.1, J12.2, J13.1, J13.2, J16.1, J16.2, Q1.2 (G1), Q1.5 (G2), R1.1, R25.1, R30.1, R31.1, R32.1, R33.1; also elsewhere on the board
VDDIO_I2C: J5.2, R14.1, R15.1

Notes on the sheet:
Function Switch
I2C Level Shifter
XMOS Headers
QSPI Header
LEDs
Arduino UNO Header
Power Header
Buttons

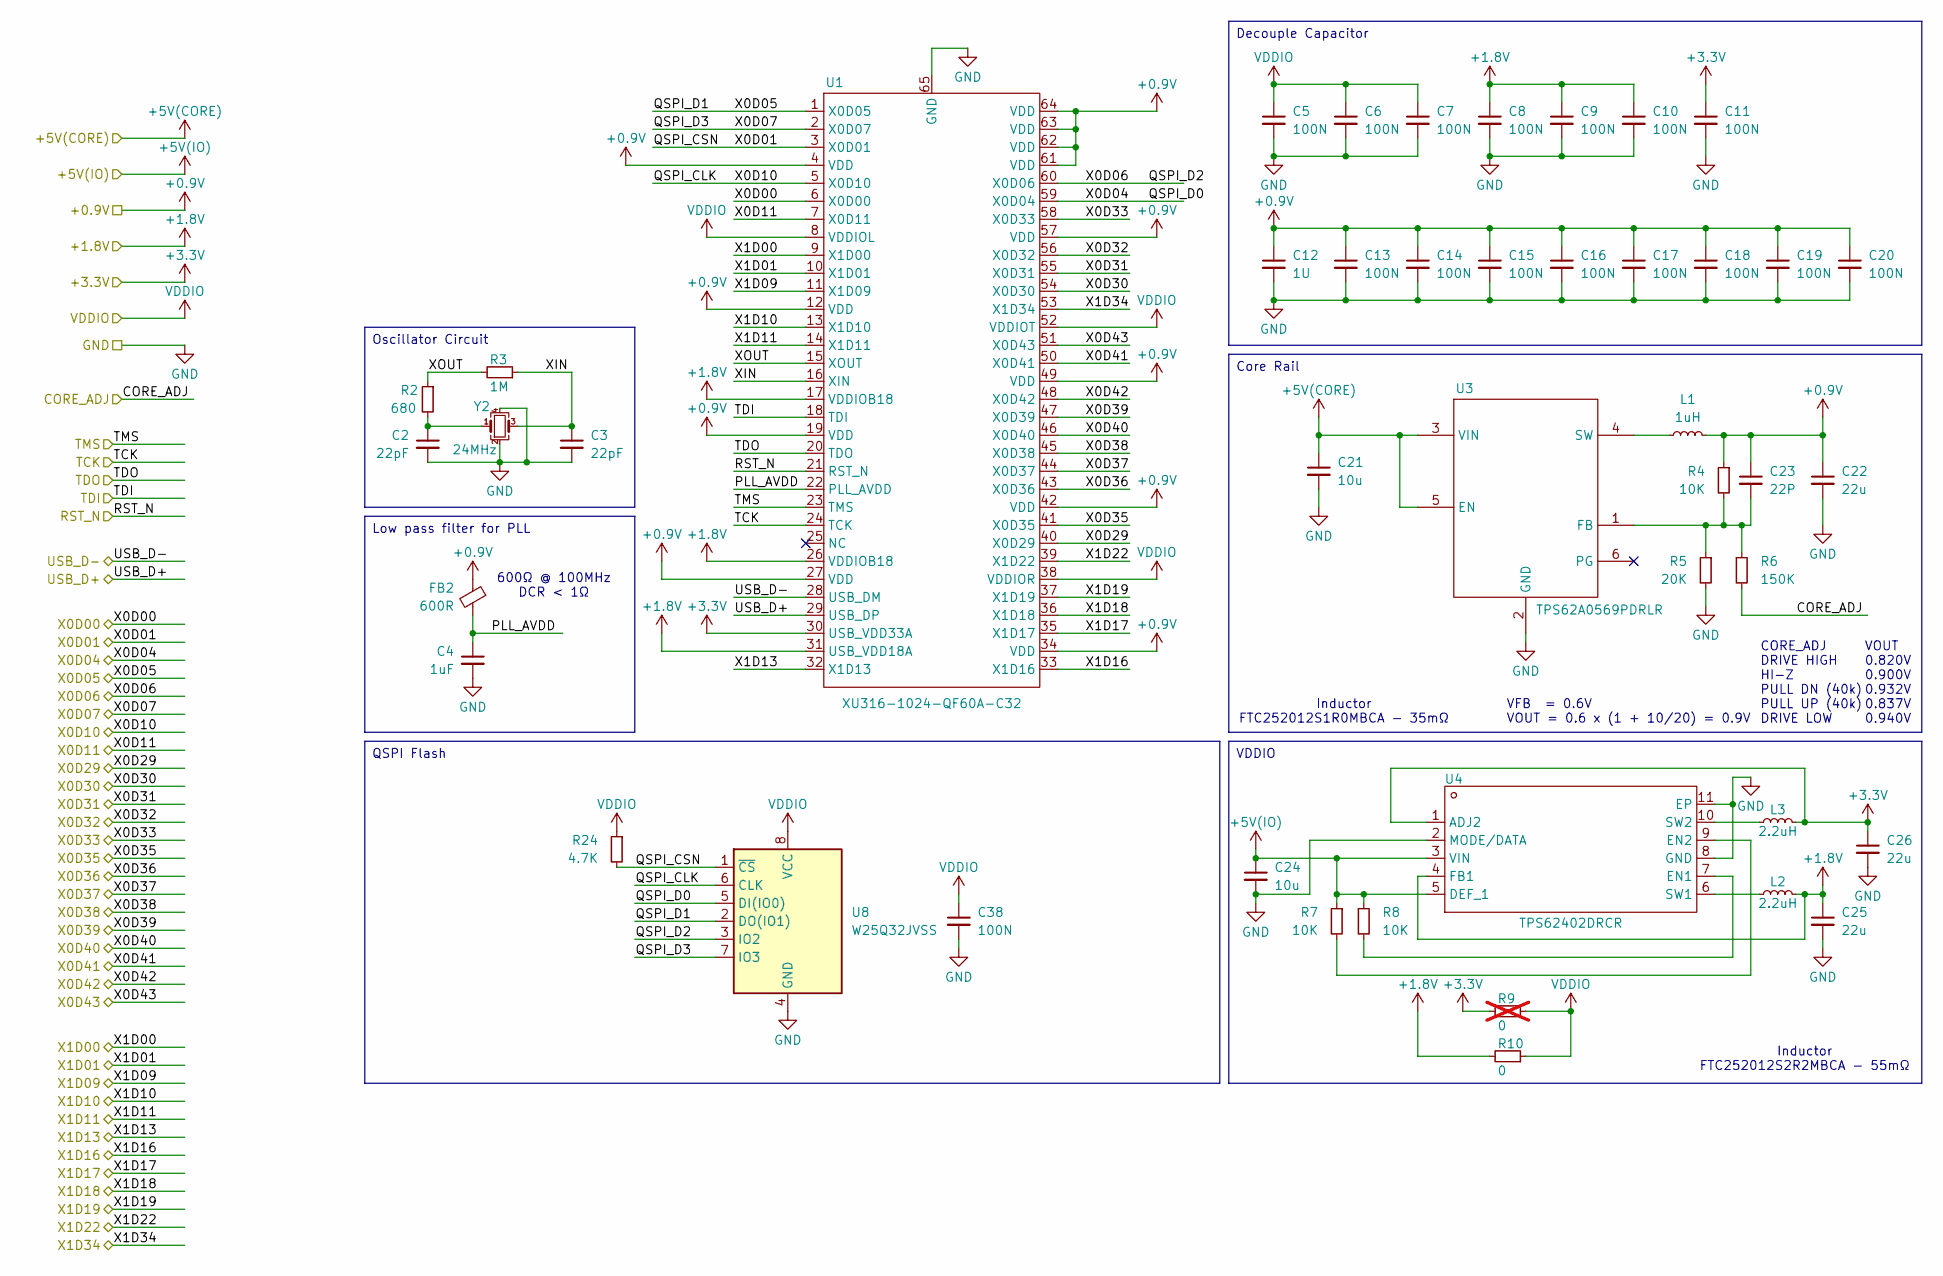
[picture p28: schematic xu316_core.kicad_sch]

Parts:
C2, C3: 22pF; C_0402_1005Metric
C4: 1uF; C_0402_1005Metric
C5, C6, C7, C8, C9, C10, C11, C13, C14, C15, C16, C17, C18, C19, C20, C38: 100N; C_0402_1005Metric
C12: 1U; C_0402_1005Metric
C21, C24: 10u; C_0603_1608Metric
C22, C25, C26: 22u; C_0402_1005Metric
C23: 22P; C_0402_1005Metric
FB2: 600R; L_0402_1005Metric
L1: 1uH; L_1008_2520Metric
L2, L3: 2.2uH; L_1008_2520Metric
R2: 680; R_0402_1005Metric
R3: 1M; R_0402_1005Metric
R4, R7, R8: 10K; R_0402_1005Metric
R5: 20K; R_0402_1005Metric
R6: 150K; R_0402_1005Metric
R9: 0; R_0805_2012Metric; not fitted
R10: 0; R_0805_2012Metric
R24: 4.7K; R_0402_1005Metric
U1: XU316-1024-QF60A-C32; QFN-60_L7.0-W7.0-P0.40-TL-EP_XU316-1024; Manufacturer Part XU316-1024-QF60A-C32; LCSC Part Name XU316-1024-QF60A-C32
U3: TPS62A0569PDRLR; sot-563-6
U4: TPS62402DRCR; VSON-10_L3.0-W3.0-P0.50-BL-EP_TPS62410DRCR; Manufacturer Part TPS62402DRCR; LCSC Part Name 降压型 400mA 2.5V~6V
U8: W25Q32JVSS; SOIC-8_5.23x5.23mm_P1.27mm
Y2: 24MHz; Crystal_SMD_2016-4Pin_2.0x1.6mm; part XTM20024000JT00351001

Connections:
+0.9V: C12.1, C13.1, C14.1, C15.1, C16.1, C17.1, C18.1, C19.1, C20.1, C22.1, C23.1, FB2.1, L1.2, R4.1, U1.4 (VDD), U1.12 (VDD), U1.19 (VDD), U1.27 (VDD), U1.34 (VDD), U1.42 (VDD), U1.49 (VDD), U1.57 (VDD), U1.61 (VDD), U1.62 (VDD), U1.63 (VDD), U1.64 (VDD)
+1.8V: C8.1, C9.1, C10.1, C25.1, L2.2, R10.2, U1.17 (VDDIOB18), U1.26 (VDDIOB18), U1.31 (USB_VDD18A), U4.4 (FB1); also elsewhere on the board
+3.3V: C11.1, C26.1, L3.2, R9.2, U1.30 (USB_VDD33A), U4.1 (ADJ2); also elsewhere on the board
+5V(CORE): C21.1, U3.3 (VIN), U3.5 (EN); also elsewhere on the board
+5V(IO): C24.1, R7.1, R8.1, U4.3 (VIN), U4.5 (DEF_1); also elsewhere on the board
/CORE_ADJ: R6.2; also elsewhere on the board
/RST_N: U1.21 (RST_N); also elsewhere on the board
/TCK: U1.24 (TCK); also elsewhere on the board
/TDI: U1.18 (TDI); also elsewhere on the board
/TDO: U1.20 (TDO); also elsewhere on the board
/TMS: U1.23 (TMS); also elsewhere on the board
/USB_D+: U1.28 (USB_DM); also elsewhere on the board
/USB_D-: U1.29 (USB_DP); also elsewhere on the board
/X0P1A0: U1.6 (X0D00); also elsewhere on the board
/X0P1B0: R24.2, U1.3 (X0D01), U8.1 (~CS); also elsewhere on the board
/X0P1C0: U1.5 (X0D10), U8.6 (CLK); also elsewhere on the board
/X0P1D0: U1.7 (X0D11); also elsewhere on the board
/X0P1L0: U1.41 (X0D35); also elsewhere on the board
/X0P16A2: U1.59 (X0D04), U8.5 (DI(IO0)); also elsewhere on the board
/X0P16A3: U1.1 (X0D05), U8.2 (DO(IO1)); also elsewhere on the board
/X0P16A4: U1.60 (X0D06), U8.3 (IO2); also elsewhere on the board
/X0P16A5: U1.2 (X0D07), U8.7 (IO3); also elsewhere on the board
/X0P16B3: U1.40 (X0D29); also elsewhere on the board
/X0P16B4: U1.54 (X0D30); also elsewhere on the board
/X0P16B5: U1.55 (X0D31); also elsewhere on the board
/X0P16B6: U1.56 (X0D32); also elsewhere on the board
/X0P16B7: U1.58 (X0D33); also elsewhere on the board
/X0P16B8: U1.43 (X0D36); also elsewhere on the board
/X0P16B9: U1.44 (X0D37); also elsewhere on the board
/X0P16B10: U1.45 (X0D38); also elsewhere on the board
/X0P16B11: U1.47 (X0D39); also elsewhere on the board
/X0P16B12: U1.46 (X0D40); also elsewhere on the board
/X0P16B13: U1.50 (X0D41); also elsewhere on the board
/X0P16B14: U1.48 (X0D42); also elsewhere on the board
/X0P16B15: U1.51 (X0D43); also elsewhere on the board
/X1P1A0: U1.9 (X1D00); also elsewhere on the board
/X1P1B0: U1.10 (X1D01); also elsewhere on the board
/X1P1C0: U1.13 (X1D10); also elsewhere on the board
/X1P1D0: U1.14 (X1D11); also elsewhere on the board
/X1P1F0: U1.32 (X1D13); also elsewhere on the board
/X1P1G0: U1.39 (X1D22); also elsewhere on the board
/X1P1K0: U1.53 (X1D34); also elsewhere on the board
/X1P16A7: U1.11 (X1D09); also elsewhere on the board
/XL_DN0: U1.35 (X1D17); also elsewhere on the board
/XL_DN1: U1.33 (X1D16); also elsewhere on the board
/XU316 Core/PLL_AVDD: C4.1, FB2.2, U1.22 (PLL_AVDD)
/XU316 Core/X1D18: U1.36 (X1D18); also elsewhere on the board
/XU316 Core/X1D19: U1.37 (X1D19); also elsewhere on the board
/XU316 Core/XIN: C3.1, R3.1, U1.16 (XIN), Y2.3
/XU316 Core/XOUT: R2.1, R3.2, U1.15 (XOUT)
GND: C2.2, C3.2, C4.2, C5.2, C6.2, C7.2, C8.2, C9.2, C10.2, C11.2, C12.2, C13.2, C14.2, C15.2, C16.2, C17.2, C18.2, C19.2, C20.2, C21.2, C22.2, C24.2, C25.2, C26.2, C38.2, R5.2, U1.65 (GND), U3.2 (GND), U4.2 (MODE/DATA), U4.8 (GND), U4.11 (EP), U8.4 (GND), Y2.2, Y2.4; also elsewhere on the board
unnamed: C2.1, R2.2, Y2.1
unnamed: C23.2, R4.2, R5.1, R6.1, U3.1 (FB)
unnamed: L1.1, U3.4 (SW)
unnamed: R8.2, U4.7 (EN1)
unnamed: R7.2, U4.9 (EN2)
unnamed: L2.1, U4.6 (SW1)
unnamed: L3.1, U4.10 (SW2)
VDDIO: C5.1, C6.1, C7.1, C38.1, R9.1, R10.1, R24.1, U1.8 (VDDIOL), U1.38 (VDDIOR), U1.52 (VDDIOT), U8.8 (VCC); also elsewhere on the board

Notes on the sheet:
CORE_ADJ DRIVE HIGH HI-Z PULL DN (40k) PULL UP (40k) DRIVE LOW
Inductor FTC252012S1R0MBCA - 35mΩ
VOUT 0.820V 0.900V 0.932V 0.837V 0.940V
Inductor FTC252012S2R2MBCA - 55mΩ
600Ω @ 100MHz DCR < 1Ω
VFB = 0.6V VOUT = 0.6 x (1 + 10/20) = 0.9V
Core Rail
Decouple Capacitor
Low pass filter for PLL
VDDIO
QSPI Flash
Oscillator Circuit

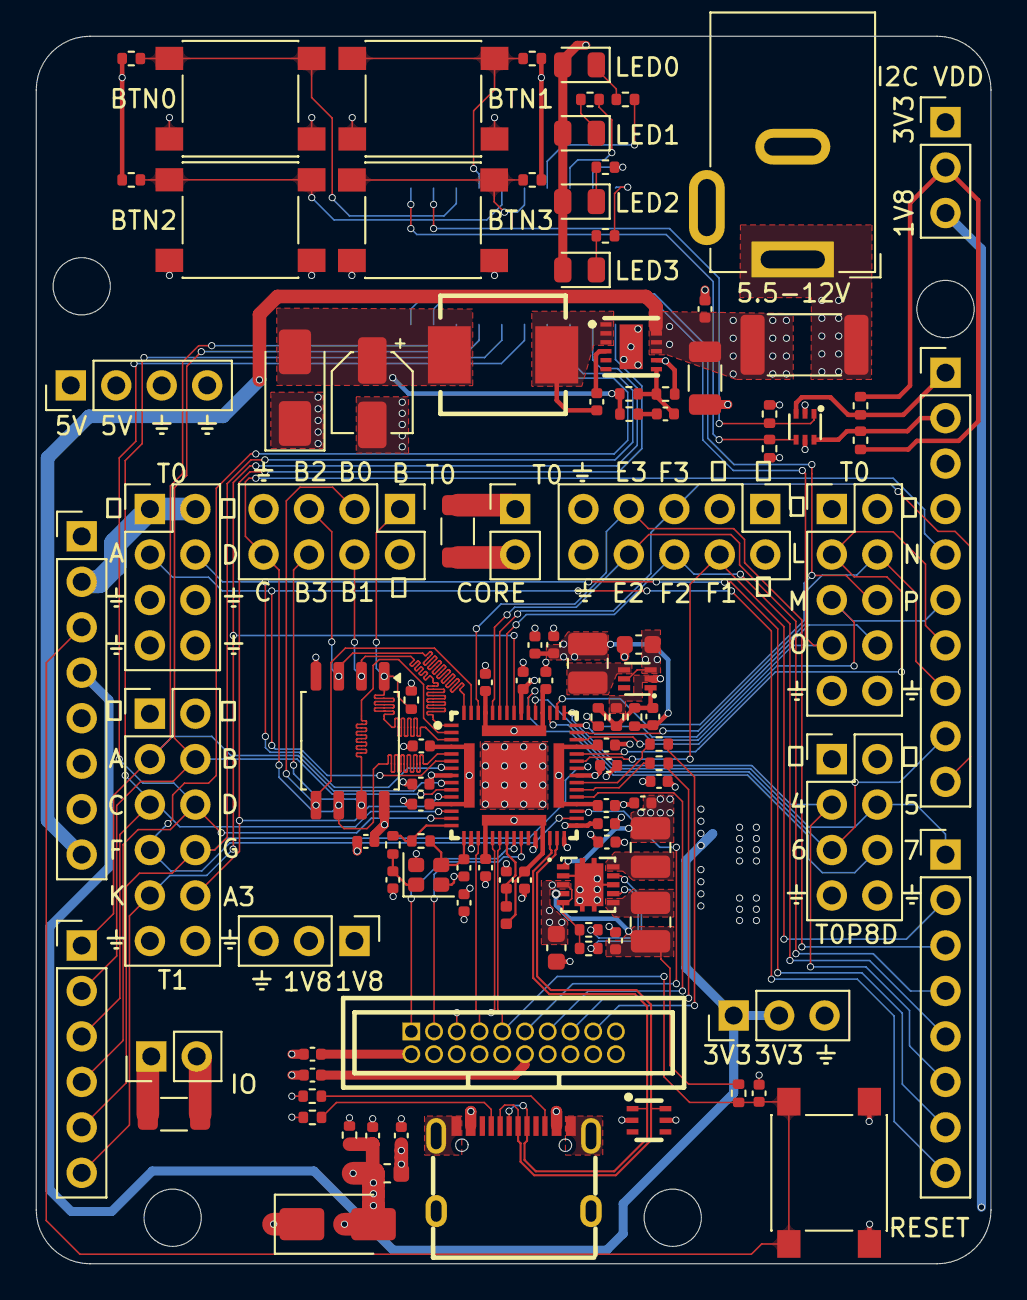
[picture p29: board xu316_core_board.kicad_pcb from above]

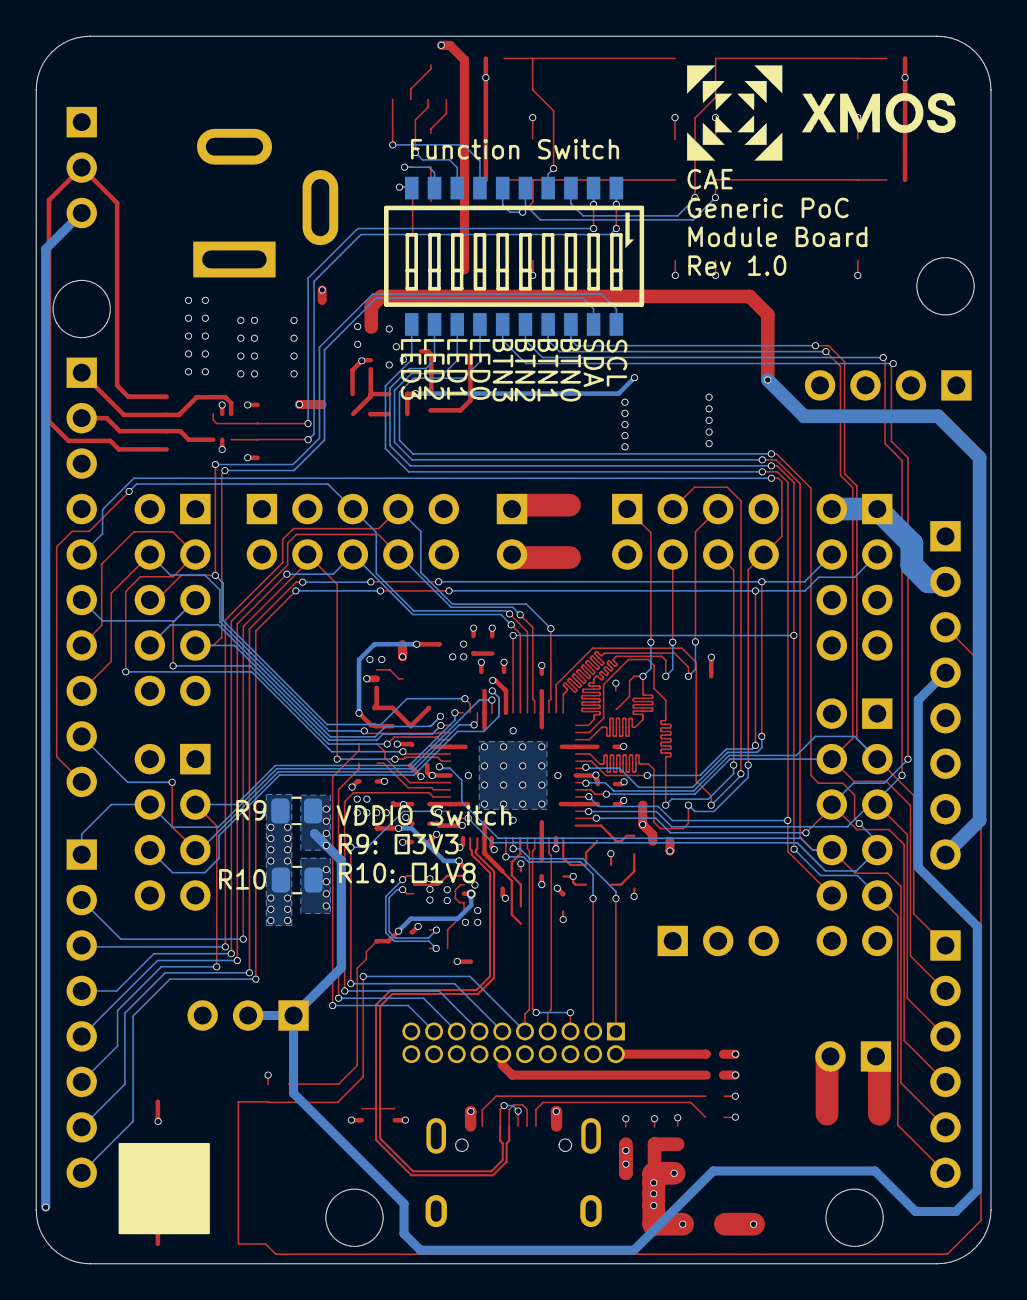
[picture p30: board xu316_core_board.kicad_pcb from below]

Board: 4 copper layers, 53.3 x 68.6 mm, 119 parts (3 on the bottom side), 90 nets.
