LeslieXMOS/XU316-QF60-Development-Board-Hardware/(commit log)

2026-09-11 Remove old schematic files
    [arduino_header.kicad_sch, arduino_uno_header.kicad_sch, power.kicad_sch]
2026-09-22 start routing
    [io_headers.kicad_sch, xu316_core.kicad_sch, xu316_core_board.kicad_pcb, xu316_core_board.kicad_sch]
2026-09-22 Routed the power rail
    [xu316_core_board.kicad_pcb]
2026-09-23 Updated schem; Routed most of the IO
    [IND-SMD_L7.0-W6.6-H3.0.step, io_headers.kicad_sch, xu316_core.kicad_sch, xu316_core_board.kicad_pcb, xu316_core_board.kicad_sch]
2026-09-24 Finish routing
    [io_headers.kicad_sch, xu316_core_board.kicad_pcb, xu316_core_board.kicad_sch]
2026-09-25 Added XMOS logo
    [xu316_core_board.kicad_pcb]
2026-09-27 Finalize the design
    [xu316_core_board.kicad_sch]
2026-09-28 Ready to production
    [xu316_core.kicad_sch, xu316_core_board.kicad_pcb, xu316_core_board.kicad_sch]
2026-09-29 Updated for manufacture
    [xu316_core.kicad_sch, xu316_core_board.kicad_pcb, xu316_core_board.kicad_sch]
